martonmiklos/DJI_RC_N1_ESP32/README.md

## DJI RC-N1 ESP32

This is a replacement PCB to the DJI RC-N1 (RC231) which features an ESP32.

Support for BLE toys is planned like Shell BBurago RC cars, LEGO 42410, etc.

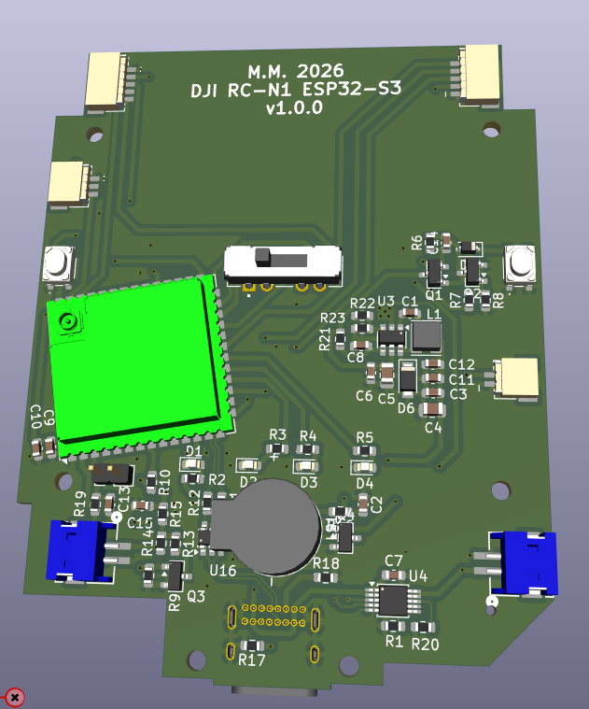
[picture p1: boardview.png]
Boardview


It is WIP!
