martonmiklos/DJI_RC_N1_ESP32/docs/rc_n1_top.png

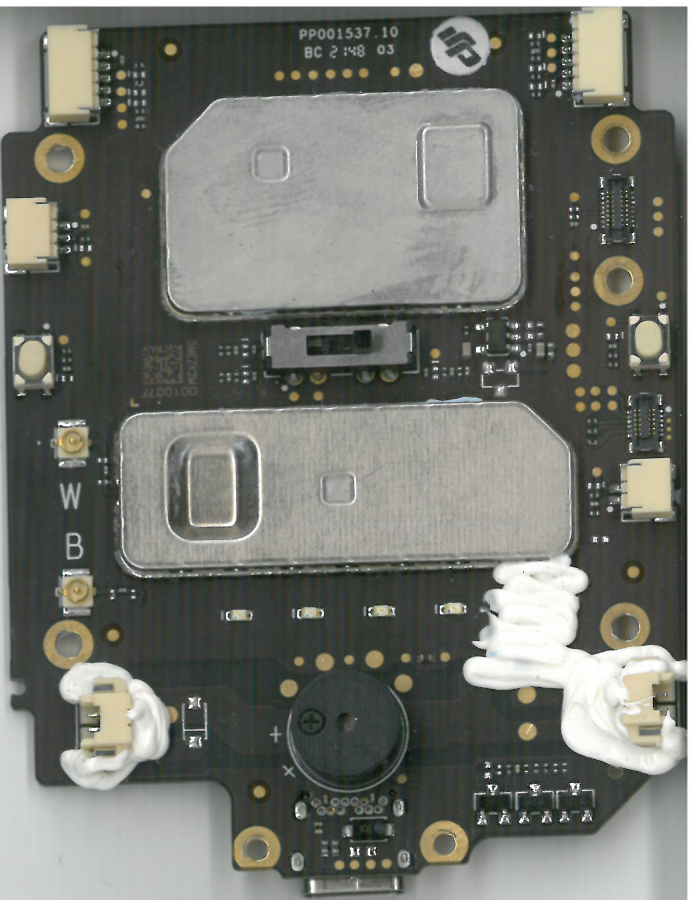
docs/rc_n1_top.png
