martonmiklos/DJI_RC_N1_ESP32/DJI_RC_N1_ESP32.step

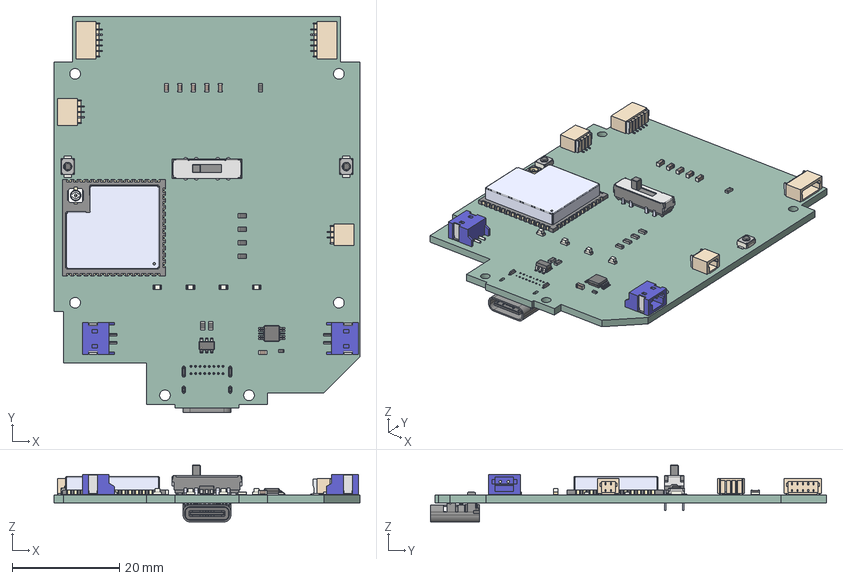
[picture p4: CAD file, 2026-10-19]
DJI_RC_N1_ESP32.step
57.0 x 73.9 x 10.6 mm
MSOP-10_3x3mm_P0.5mm
LED_0603_1608Metric x 4
6651xx131822_PIN x 15
6651xx131822_PATTE x 8
SW_SPST_B3U-1000P x 2
C_0603_1608Metric x 6
SOT-23-6
ESP32-S3-WROOM-1U-N16R8
R_0603_1608Metric x 7
R_0402_1005Metric
S2B-ZR-SM4A x 2
JS203011CQN
USB_C_Receptacle_GCT_USB4085
DJI_RC_N1_ESP32-unsaved-export-TQ26zq_PCB
