martonmiklos/DJI_RC_N1_ESP32/(list of files, cad)

Other CAD files:
DJI_RC_N1_ESP32.stl
