martonmiklos/DJI_RC_N1_ESP32/DJI_RC_N1_ESP32.kicad_pcb

## KiCad design DJI_RC_N1_ESP32.kicad_pcb (2026-10-22)

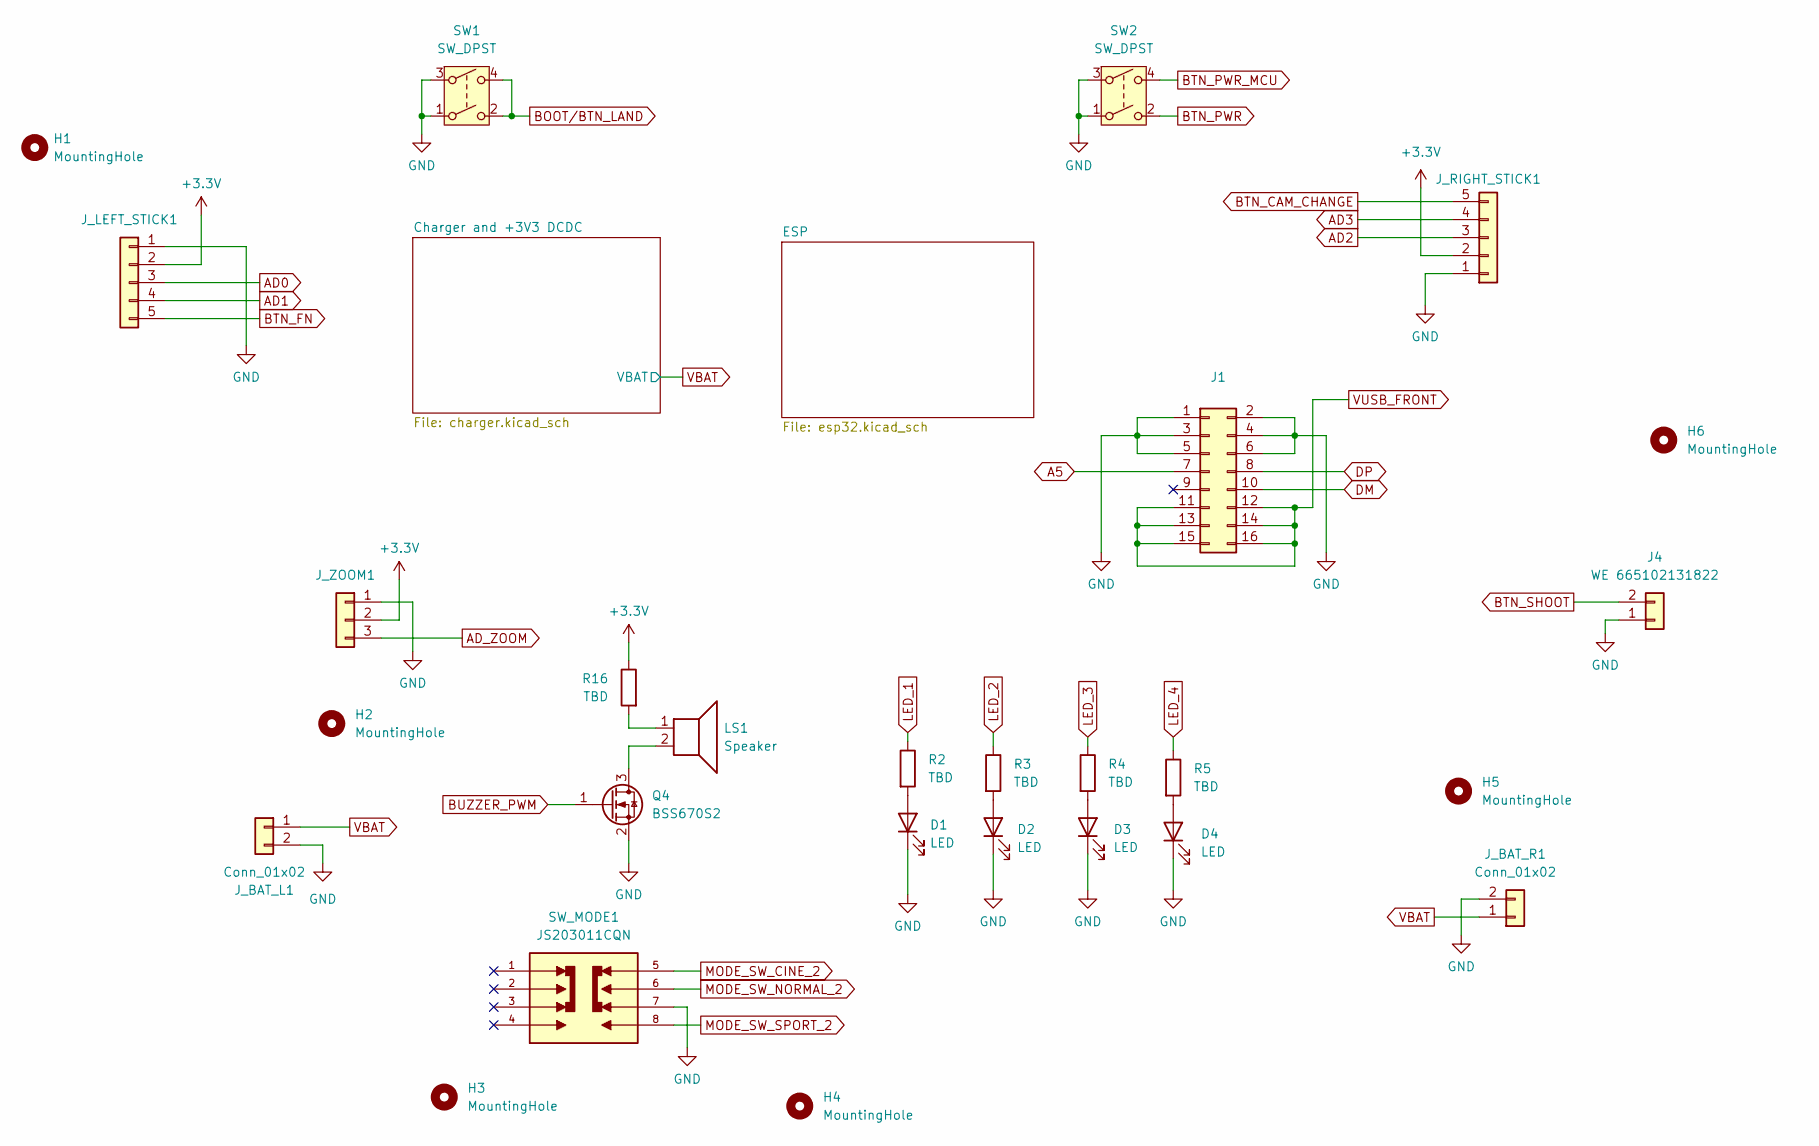
[picture p5: schematic DJI_RC_N1_ESP32.kicad_sch]

Parts:
D1, D2, D3, D4: LED; LED_0603_1608Metric
H1, H2, H3, H4, H5, H6: MountingHole; MountingHole_2mm
J1: Conn_02x08_Odd_Even
J4: WE 665102131822; J_Wurth_WR-WTB_665102131822
J_BAT_L1: Conn_01x02; CONN_S2B-ZR-SM4A-TFLFSN_JST
J_BAT_R1: Conn_01x02; CONN_S2B-ZR-SM4A-TFLFSN_JST
J_LEFT_STICK1: WE 665105131822; J_Wurth_WR-WTB_665105131822
J_RIGHT_STICK1: WE 665105131822; J_Wurth_WR-WTB_665105131822
J_ZOOM1: WE 665103131822; J_Wurth_WR-WTB_665103131822
LS1: Speaker; XDCR_CMT-9605-85T
Q4: BSS670S2; SOT-23
R2, R3, R4, R5, R16: TBD; R_0603_1608Metric
SW1, SW2: SW_DPST; SKRPABE010
SW_MODE1: JS203011CQN; SW_JS203011CQN; PARTREV VL

Connections:
+3.3V: J_LEFT_STICK1.2, J_RIGHT_STICK1.2, J_ZOOM1.2, R16.1; also elsewhere on the board
AD0: J_LEFT_STICK1.3; also elsewhere on the board
AD1: J_LEFT_STICK1.4; also elsewhere on the board
AD2: J_RIGHT_STICK1.3; also elsewhere on the board
AD3: J_RIGHT_STICK1.4; also elsewhere on the board
AD_ZOOM: J_ZOOM1.3; also elsewhere on the board
BOOT/BTN_LAND: SW1.2, SW1.4; also elsewhere on the board
BTN_CAM_CHANGE: J_RIGHT_STICK1.5; also elsewhere on the board
BTN_FN: J_LEFT_STICK1.5; also elsewhere on the board
BTN_PWR: SW2.2; also elsewhere on the board
BTN_PWR_MCU: SW2.4; also elsewhere on the board
BTN_SHOOT: J4.2; also elsewhere on the board
BUZZER_PWM: Q4.1 (G); also elsewhere on the board
GND: D1.1 (K), D2.1 (K), D3.1 (K), D4.1 (K), J1.1, J1.2, J1.3, J1.4, J1.5, J1.6, J4.1, J_BAT_L1.2, J_BAT_R1.2, J_LEFT_STICK1.1, J_RIGHT_STICK1.1, J_ZOOM1.1, Q4.2 (S), SW1.1, SW1.3, SW2.1, SW2.3, SW_MODE1.7; also elsewhere on the board
LED_1: R2.1; also elsewhere on the board
LED_2: R3.1; also elsewhere on the board
LED_3: R4.1; also elsewhere on the board
LED_4: R5.1; also elsewhere on the board
MODE_SW_CINE_2: SW_MODE1.5; also elsewhere on the board
MODE_SW_NORMAL_2: SW_MODE1.6; also elsewhere on the board
MODE_SW_SPORT_2: SW_MODE1.8; also elsewhere on the board
unnamed: D1.2 (A), R2.2
unnamed: D2.2 (A), R3.2
unnamed: D3.2 (A), R4.2
unnamed: D4.2 (A), R5.2
unnamed: J1.11, J1.12, J1.13, J1.14, J1.15, J1.16
unnamed: LS1.1, R16.2
unnamed: LS1.2, Q4.3 (D)
VBAT: J_BAT_L1.1, J_BAT_R1.1; also elsewhere on the board

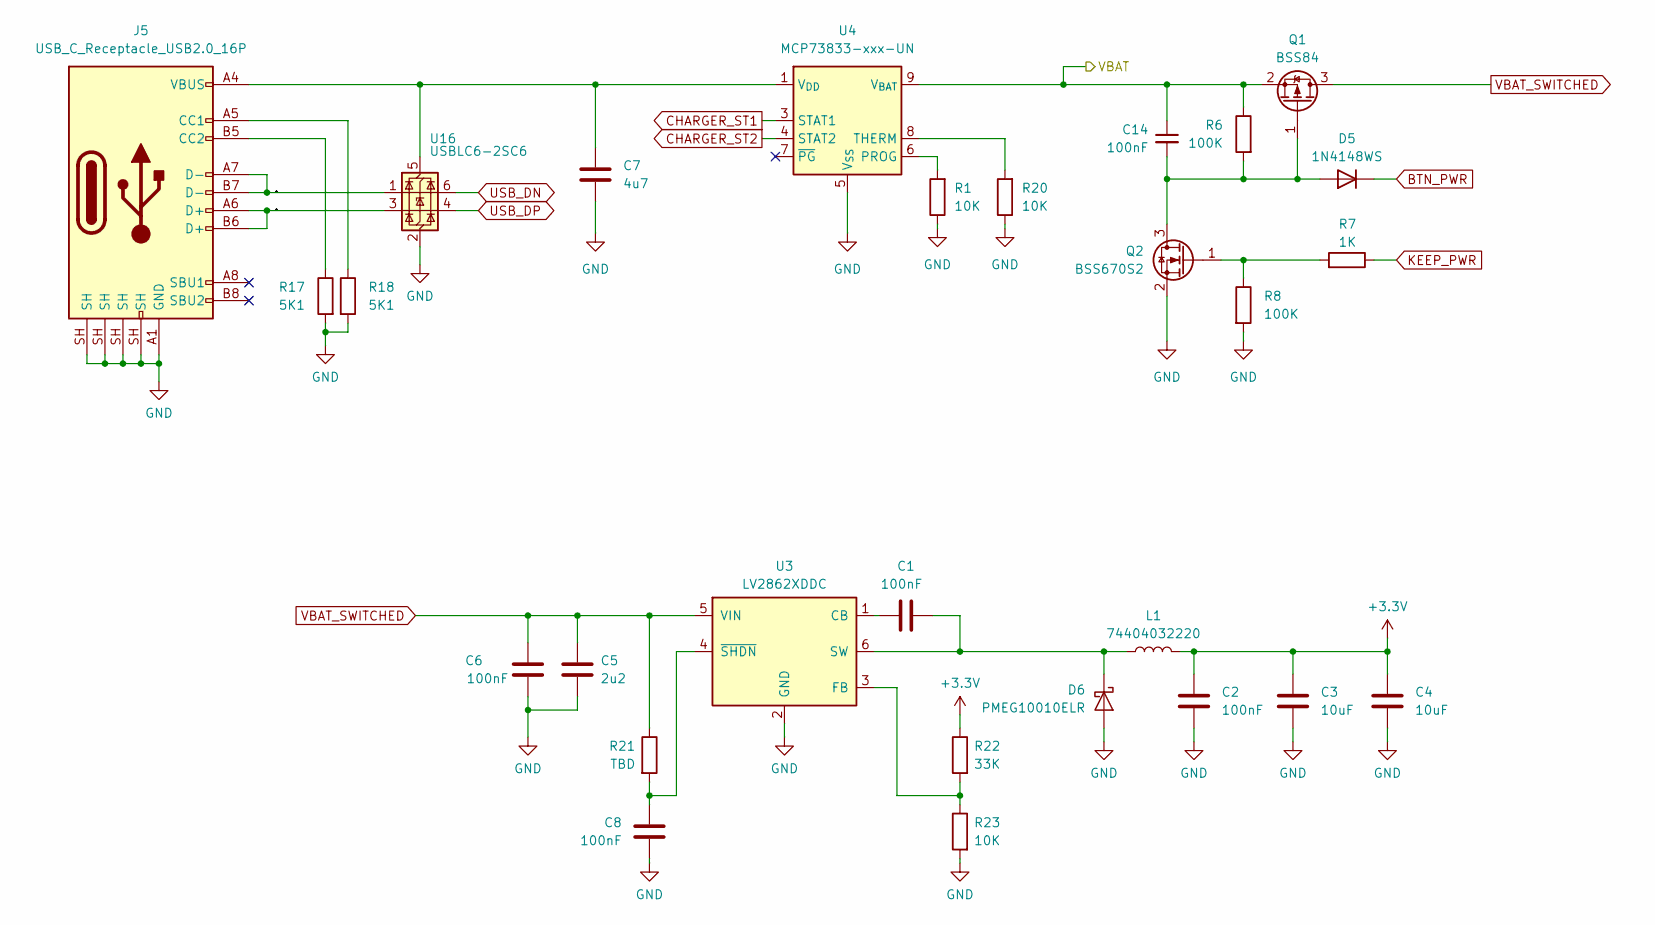
[picture p6: schematic charger.kicad_sch]

Parts:
C1, C2, C6, C8, C14: 100nF; C_0603_1608Metric
C3: 10uF; C_0603_1608Metric
C4: 10uF; C_0805_2012Metric
C5: 2u2; C_0805_2012Metric
C7: 4u7; C_0603_1608Metric
D5: 1N4148WS; D_SOD-323
D6: PMEG10010ELR; Nexperia_CFP3_SOD-123W
J5: USB_C_Receptacle_USB2.0_16P; USB_C_Receptacle_GCT_USB4085
L1: 74404032220; L_Wuerth_MAPI-3015
Q1: BSS84; SOT-23
Q2: BSS670S2; SOT-23
R1, R20, R23: 10K; R_0603_1608Metric
R6, R8: 100K; R_0603_1608Metric
R7: 1K; R_0603_1608Metric
R17, R18: 5K1; R_0603_1608Metric
R21: TBD; R_0603_1608Metric
R22: 33K; R_0603_1608Metric
U3: LV2862XDDC; SOT-23-6
U4: MCP73833-xxx-UN; MSOP-10_3x3mm_P0.5mm
U16: USBLC6-2SC6; SOT-23-6

Connections:
+3.3V: C2.2, C3.2, C4.2, L1.2, R22.1; also elsewhere on the board
/Charger and +3V3 DCDC/USB_UNPROT_DN: J5.A7 (D-), J5.B7 (D-), U16.1 (I/O1)
/Charger and +3V3 DCDC/USB_UNPROT_DP: J5.A6 (D+), J5.B6 (D+), U16.3 (I/O2)
BTN_PWR: D5.1 (K); also elsewhere on the board
CHARGER_ST1: U4.3 (STAT1); also elsewhere on the board
CHARGER_ST2: U4.4 (STAT2); also elsewhere on the board
GND: C2.1, C3.1, C4.1, C5.1, C6.1, C7.2, C8.1, D6.2 (A), J5.A1 (GND), J5.A12 (GND), J5.B1 (GND), J5.B12 (GND), J5.SH, Q2.2 (S), R1.1, R8.2, R17.2, R18.2, R20.1, R23.2, U3.2 (GND), U4.5 (V_{SS}), U16.2 (GND); also elsewhere on the board
KEEP_PWR: R7.1; also elsewhere on the board
unnamed: C14.2, D5.2 (A), Q1.1 (G), Q2.3 (D), R6.2
unnamed: C1.2, D6.1 (K), L1.1, U3.6 (SW)
unnamed: J5.A5 (CC1), R18.1
unnamed: J5.B5 (CC2), R17.1
unnamed: Q2.1 (G), R7.2, R8.1
unnamed: C1.1, U3.1 (CB)
unnamed: R22.2, R23.1, U3.3 (FB)
unnamed: C8.2, R21.2, U3.4 (~SHDN)
unnamed: R1.2, U4.6 (PROG)
unnamed: R20.2, U4.8 (THERM)
unnamed: C7.1, J5.A4 (VBUS), J5.A9 (VBUS), J5.B4 (VBUS), J5.B9 (VBUS), U4.1 (V_{DD}), U4.2 (V_{DD}), U16.5 (VBUS)
USB_DN: U16.6 (I/O1); also elsewhere on the board
USB_DP: U16.4 (I/O2); also elsewhere on the board
VBAT: C14.1, Q1.2 (S), R6.1, U4.9 (V_{BAT}), U4.10 (V_{BAT}); also elsewhere on the board
VBAT_SWITCHED: C5.2, C6.2, Q1.3 (D), R21.1, U3.5 (VIN)

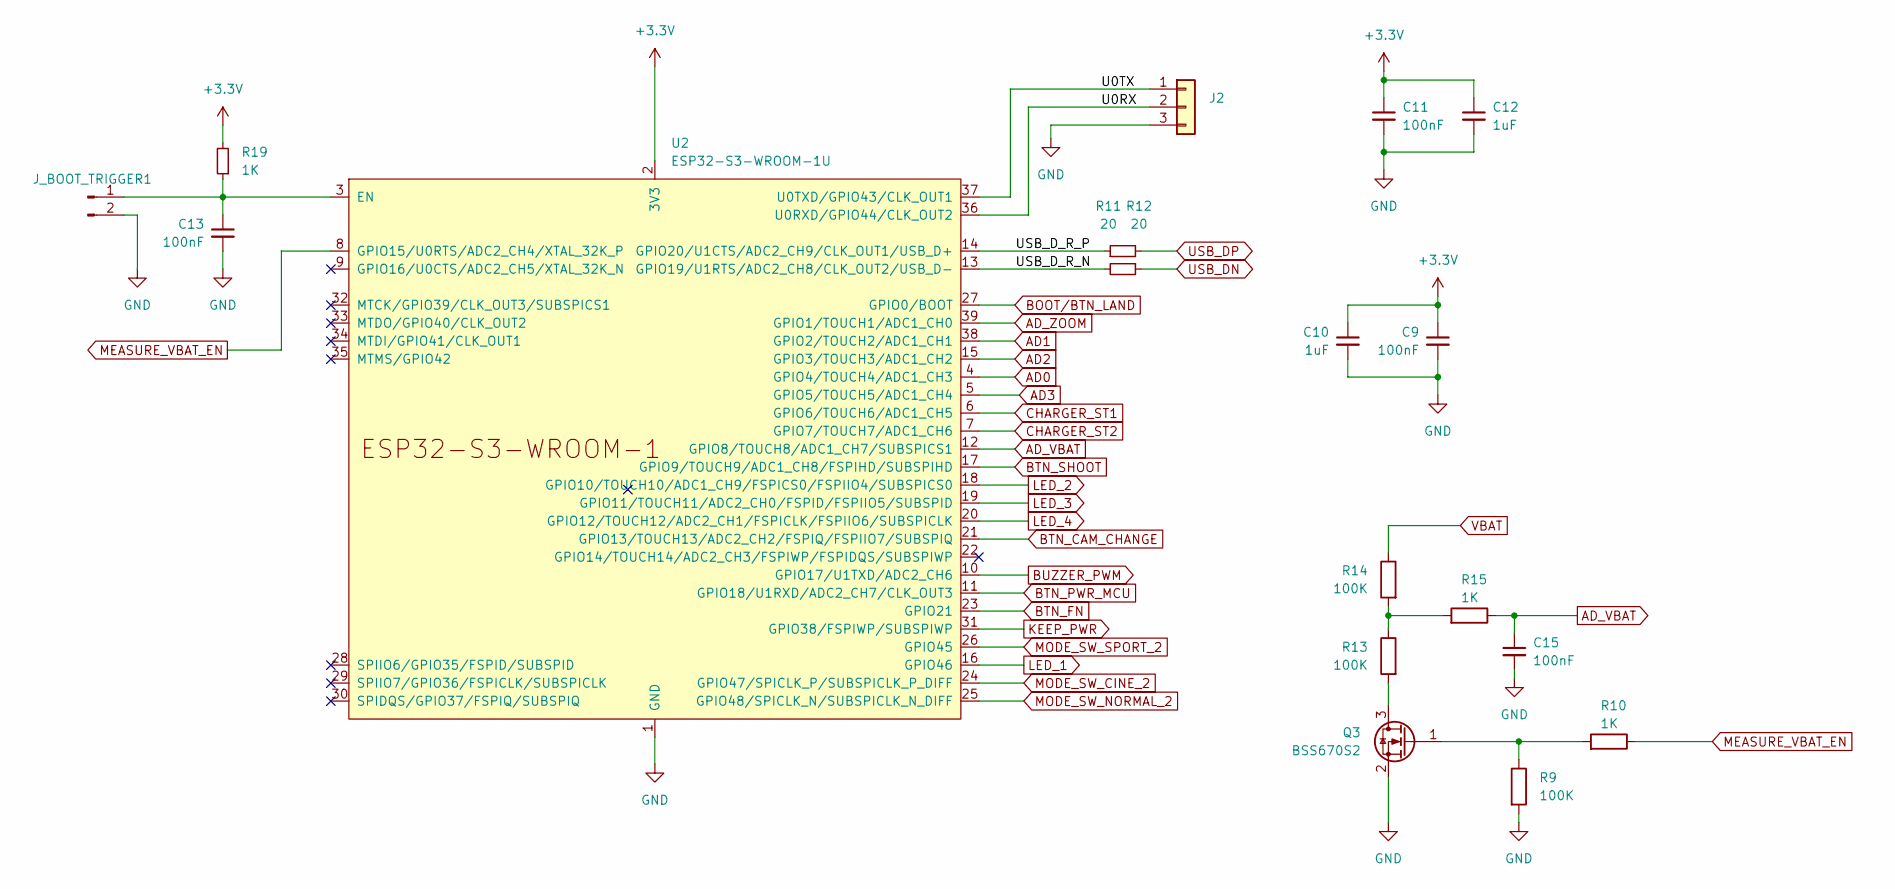
[picture p7: schematic esp32.kicad_sch]

Parts:
C9, C11, C13, C15: 100nF; C_0603_1608Metric
C10, C12: 1uF; C_0603_1608Metric
J2: Conn_01x03; PinHeader_1x03_P2.54mm_Vertical
J_BOOT_TRIGGER1: Conn_01x02_Pin; PinHeader_1x02_P2.00mm_Vertical
Q3: BSS670S2; SOT-23
R9, R13, R14: 100K; R_0603_1608Metric
R10, R15, R19: 1K; R_0603_1608Metric
R11, R12: 20; R_0603_1608Metric
U2: ESP32-S3-WROOM-1U

Connections:
+3.3V: C9.1, C10.1, C11.1, C12.1, R19.2, U2.2 (3V3); also elsewhere on the board
/ESP/U0RX: J2.2, U2.36 (U0RXD/GPIO44/CLK_OUT2)
/ESP/U0TX: J2.1, U2.37 (U0TXD/GPIO43/CLK_OUT1)
/ESP/USB_D_R_N: R12.2, U2.13 (GPIO19/U1RTS/ADC2_CH8/CLK_OUT2/USB_D-)
/ESP/USB_D_R_P: R11.1, U2.14 (GPIO20/U1CTS/ADC2_CH9/CLK_OUT1/USB_D+)
AD0: U2.4 (GPIO4/TOUCH4/ADC1_CH3); also elsewhere on the board
AD1: U2.38 (GPIO2/TOUCH2/ADC1_CH1); also elsewhere on the board
AD2: U2.15 (GPIO3/TOUCH3/ADC1_CH2); also elsewhere on the board
AD3: U2.5 (GPIO5/TOUCH5/ADC1_CH4); also elsewhere on the board
AD_VBAT: C15.1, R15.1, U2.12 (GPIO8/TOUCH8/ADC1_CH7/SUBSPICS1)
AD_ZOOM: U2.39 (GPIO1/TOUCH1/ADC1_CH0); also elsewhere on the board
BOOT/BTN_LAND: U2.27 (GPIO0/BOOT); also elsewhere on the board
BTN_CAM_CHANGE: U2.21 (GPIO13/TOUCH13/ADC2_CH2/FSPIQ/FSPIIO7/S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); also elsewhere on the board
BTN_FN: U2.23 (GPIO21); also elsewhere on the board
BTN_PWR_MCU: U2.11 (GPIO18/U1RXD/ADC2_CH7/CLK_OUT3); also elsewhere on the board
BTN_SHOOT: U2.17 (GPIO9/TOUCH9/ADC1_CH8/FSPIHD/SUBSPIHD); also elsewhere on the board
BUZZER_PWM: U2.10 (GPIO17/U1TXD/ADC2_CH6); also elsewhere on the board
CHARGER_ST1: U2.6 (GPIO6/TOUCH6/ADC1_CH5); also elsewhere on the board
CHARGER_ST2: U2.7 (GPIO7/TOUCH7/ADC1_CH6); also elsewhere on the board
GND: C9.2, C10.2, C11.2, C12.2, C13.2, C15.2, J2.3, J_BOOT_TRIGGER1.2, Q3.2 (S), R9.2, U2.1 (GND), U2.40 (GND), U2.41 (GND); also elsewhere on the board
KEEP_PWR: U2.31 (GPIO38/FSPIWP/SUBSPIWP); also elsewhere on the board
LED_1: U2.16 (GPIO46); also elsewhere on the board
LED_2: U2.18 (GPIO10/TOUCH10/ADC1_CH9/FSPICS0/FSPIIO4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); also elsewhere on the board
LED_3: U2.19 (GPIO11/TOUCH11/ADC2_CH0/FSPID/FSPIIO5/S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); also elsewhere on the board
LED_4: U2.20 (GPIO12/TOUCH12/ADC2_CH1/FSPICLK/FSPIIO6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); also elsewhere on the board
MEASURE_VBAT_EN: R10.1, U2.8 (GPIO15/U0RTS/ADC2_CH4/XTAL_32K_P)
MODE_SW_CINE_2: U2.24 (GPIO47/SPICLK_P/SUBSPICLK_P_DIFF); also elsewhere on the board
MODE_SW_NORMAL_2: U2.25 (GPIO48/SPICLK_N/SUBSPICLK_N_DIFF); also elsewhere on the board
MODE_SW_SPORT_2: U2.26 (GPIO45); also elsewhere on the board
unnamed: C13.1, J_BOOT_TRIGGER1.1, R19.1, U2.3 (EN)
unnamed: Q3.3 (D), R13.2
unnamed: Q3.1 (G), R9.1, R10.2
unnamed: R13.1, R14.2, R15.2
USB_DN: R12.1; also elsewhere on the board
USB_DP: R11.2; also elsewhere on the board
VBAT: R14.1; also elsewhere on the board

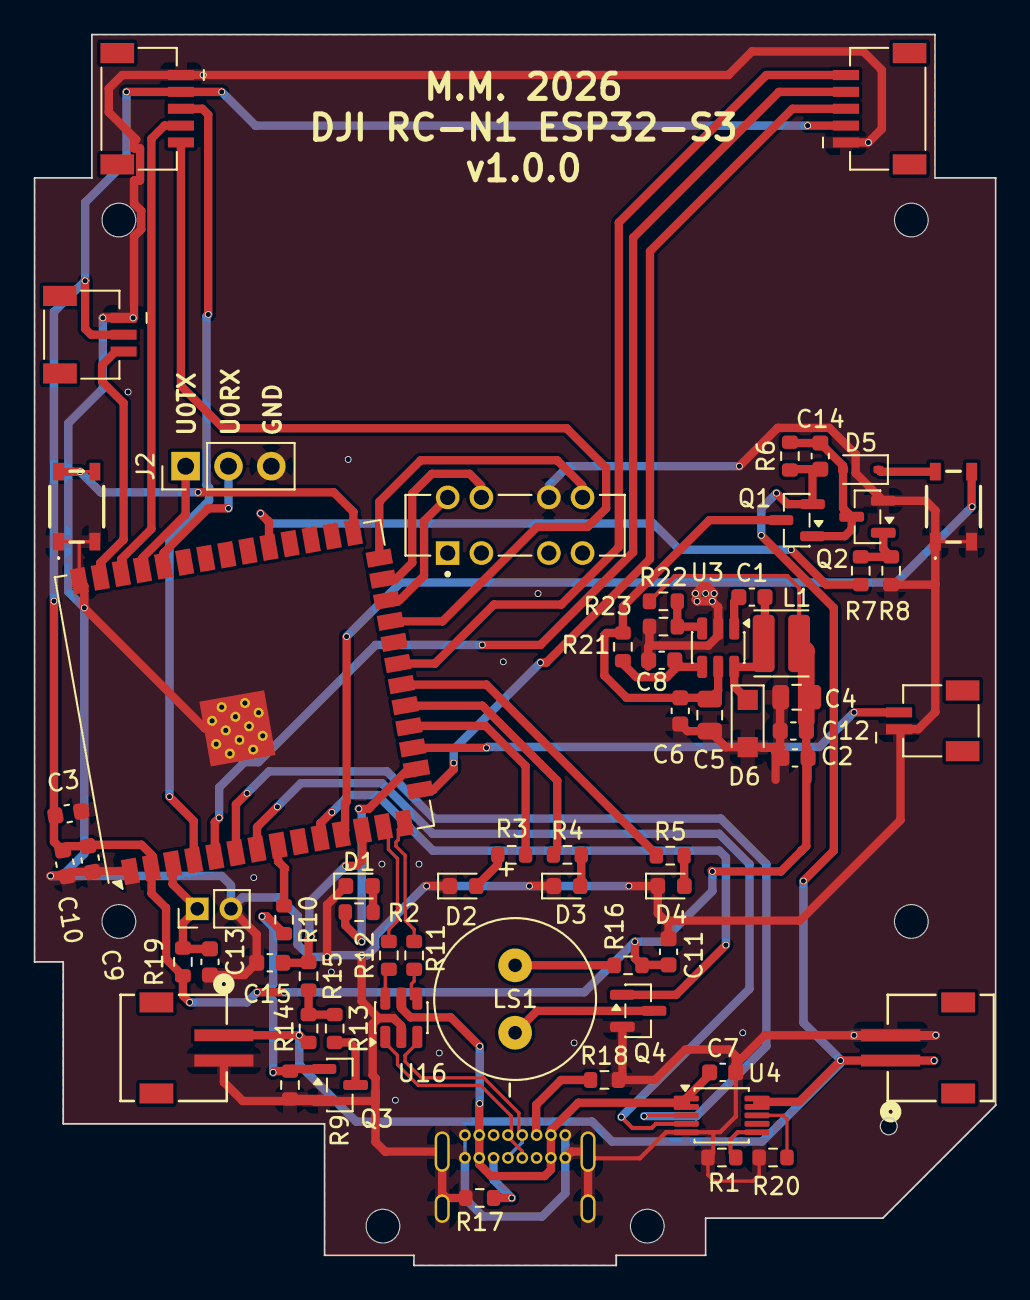
[picture p8: board DJI_RC_N1_ESP32.kicad_pcb from above]

Board: 2 copper layers, 57.0 x 73.0 mm, 72 parts (1 on the bottom side), 57 nets.
