martonmiklos/DJI_RC_N1_ESP32/(commit log)

2026-10-02 Commit before placement 3D print test
    [DJI_RC_N1_ESP32.kicad_pcb, DJI_RC_N1_ESP32.kicad_sch]
2026-10-02 Fix holes positions after 3D print test
    [DJI_RC_N1_ESP32.kicad_pcb]
2026-10-02 Add README
    [DJI_RC_N1_ESP32.kicad_sch]
2026-10-04 ERC pass, Daily save
    [DJI_RC_N1_ESP32.kicad_pcb, DJI_RC_N1_ESP32.kicad_sch, charger.kicad_sch, esp32.kicad_sch]
2026-10-15 Board had been routedy
2026-10-22 Change ESP bottom vias to 0.3 mm drill
